zaxbux/LoctekMotion-reng/docs/images/basic.pdf

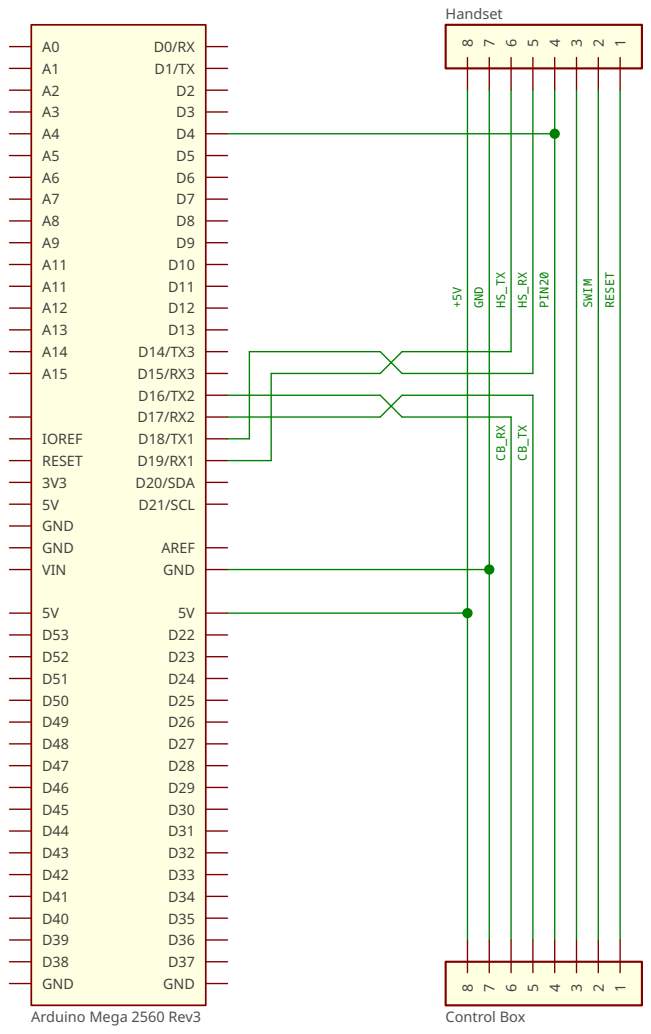
[picture p2: page 1]
