zaxbux/LoctekMotion-reng/arduino/basic/keypad.h

#include "display.h"

/**
 * - Combine values to indicate multiple buttons at the same time.
 * - Send `None` to get control box to send display bytes.
 */
enum ButtonState
{
	/** Button press */
	None = 0x0000,
	/** `▲` Up */
	Raise = 0x0100,
	/** `▼` Down */
	Lower = 0x0200,
	/** `1` Preset 1 */
	Preset1 = 0x0400,
	/** `2` Preset 2*/
	Preset2 = 0x0800,
	/** `3` Preset 3*/
	Preset3 = 0x1000,
	/** `M` Preset save */
	Save = 0x2000,
	/** `A` Reminder */
	Remind = 0x4000,
};

// Sent to CB
static const uint8_t command_none[] = {0x9b, 0x06, 0x02, 0x00, 0x00, 0x6c, 0xa1, 0x9d};
static const uint8_t command_raise[] = {0x9b, 0x06, 0x02, 0x01, 0x00, 0xfc, 0xa0, 0x9d};
static const uint8_t command_lower[] = {0x9b, 0x06, 0x02, 0x02, 0x00, 0x0c, 0xa0, 0x9d};
static const uint8_t command_save[] = {0x9b, 0x06, 0x02, 0x20, 0x00, 0xac, 0xb8, 0x9d};
static const uint8_t command_remind[] = {0x9b, 0x06, 0x02, 0x40, 0x00, 0x54, 0xac, 0x9d};
static const uint8_t command_preset1[] = {0x9b, 0x06, 0x02, 0x04, 0x00, 0xac, 0xa3, 0x9d};
static const uint8_t command_preset2[] = {0x9b, 0x06, 0x02, 0x08, 0x00, 0xac, 0xa6, 0x9d};
static const uint8_t command_preset3[] = {0x9b, 0x06, 0x02, 0x10, 0x00, 0xac, 0xac, 0x9d};
static const uint8_t command_preset4[] = {0x9b, 0x06, 0x02, 0x00, 0x01, 0xac, 0x60, 0x9d};

// Sent to HS
static const uint8_t command_alarm_on[] = {0x9B, 0x04, 0x14, 0x7F, 0x03, 0x9D};
static const uint8_t command_alarm_off[] = {0x9B, 0x04, 0x15, 0xBF, 0xC2, 0x9D};
static const uint8_t command_unknown[] = {0x9B, 0x04, 0x11, 0x7C, 0xC3, 0x9D};
